Salim653/mizuro-ksti2026-muv/program/sim-viz/samples/viz_mid120.jpg

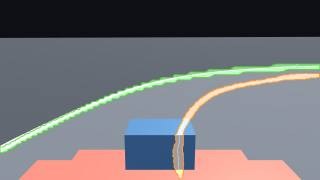
program/sim-viz/samples/viz_mid120.jpg
