Salim653/mizuro-ksti2026-muv/program/sim-viz/samples/viz_rear040.jpg

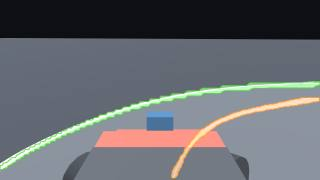
program/sim-viz/samples/viz_rear040.jpg
