Salim653/mizuro-ksti2026-muv/mechanical/README.md

# Mekanikal

Simpan CAD sasis, gambar kerja, dan catatan perakitan yang sudah terverifikasi di sini. Arah proyek saat ini: sasis FRP side-plate, penggerak roda belakang melalui satu differential terbuka, dan kemudi depan Ackermann.

## Batasan desain yang perlu dicek

- Batas lomba: lebar jejak roda 130–350 mm; wheelbase 160–550 mm; lebar total ≤400 mm; panjang ≤600 mm; tinggi ≤450 mm.
- Differential mekanis wajib; tidak boleh diganti e-differential.
- Kewajiban differential terbuka sebaiknya dikonfirmasi di Technical Meeting.
- Cek kompatibilitas hex roda 12 mm / hub M4 / driveshaft terhadap part yang benar-benar dibeli.
- FRP butuh backing plate/ring di titik pengencang; pakai cross-member agar dua rel tidak racking; isolasi tiang kamera dari getaran.
- Simpan file sumber CAD bersama hasil ekspornya; catat satuan, revisi, dan material untuk setiap part yang dirilis.

Belum ada CAD yang disalin ke folder ini; file sumber tetap berada di workspace lama.
