Salim653/mizuro-ksti2026-muv/mechanical/3d design/JETSON ORIN NANO/Design Data/Design Accelerator/Report/Spline1/Spline1.htm

### $$GrpGuide$

$$GLoads$ - $$guide_SCN1$

$$GStrength$ - $$guide_SCN2$

### $$GrpLoads$

$$description_P$ | $$designation_P$ | $$value_P$
$$description_n$ | $$designation_n$ | $$value_n$
$$description_T$ | $$designation_T$ | $$value_T$

### $$Dim$

$$description_Do$ | $$designation_Do$ | $$value_Do$
$$description_dh$ | $$designation_dh$ | $$value_dh$

### $$GrpProperties$

$$description_Km$ | $$designation_Km$ | $$value_Km$
$$description_Ks$ | $$designation_Ks$ | $$value_Ks$
$$description_Sv$ | $$designation_Sv$ | $$value_Sv$

### $$GrpMaterial$

| $$SHAFTMATERIAL$ | | $$HUBMATERIAL$

### $$GrpResults$

$$description_CHECK$ | $$value_CHECK$
$$description_dmin$ | $$designation_dmin$ | $$value_dmin$
$$description_lmin$ | $$designation_lmin$ | $$value_lmin$

##### $$Shaft$

$$description_pAc$ | $$designation_pAc$ | $$value_pAc$
$$description_S2$ | $$designation_S2$ | $$value_S2$

##### $$Hub$

$$description_Tauc$ | $$designation_Tauc$ | $$value_Tauc$
$$description_S3$ | $$designation_S3$ | $$value_S3$

### $$ErrorManager$

$$ErrorManagerMessages$
