Salim653/mizuro-ksti2026-muv/program/arena-3d/sanity_overlay.png

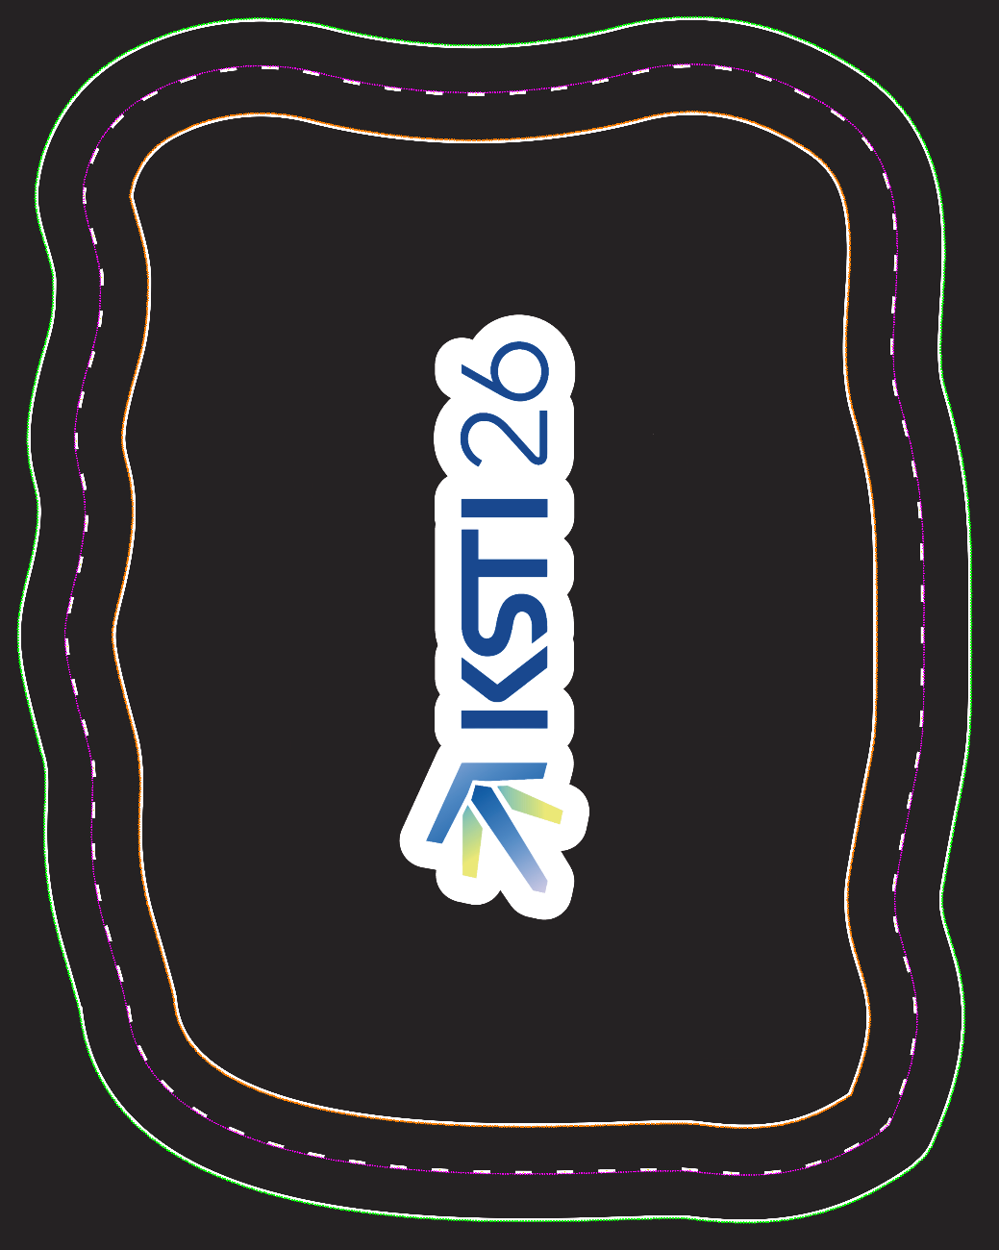
program/arena-3d/sanity_overlay.png
