Salim653/mizuro-ksti2026-muv/program/sim-viz/samples/viz_rear120.jpg

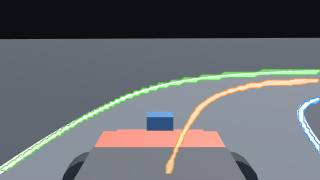
program/sim-viz/samples/viz_rear120.jpg
