Salim653/mizuro-ksti2026-muv/mechanical/3d design/BOX SPIDER.stp

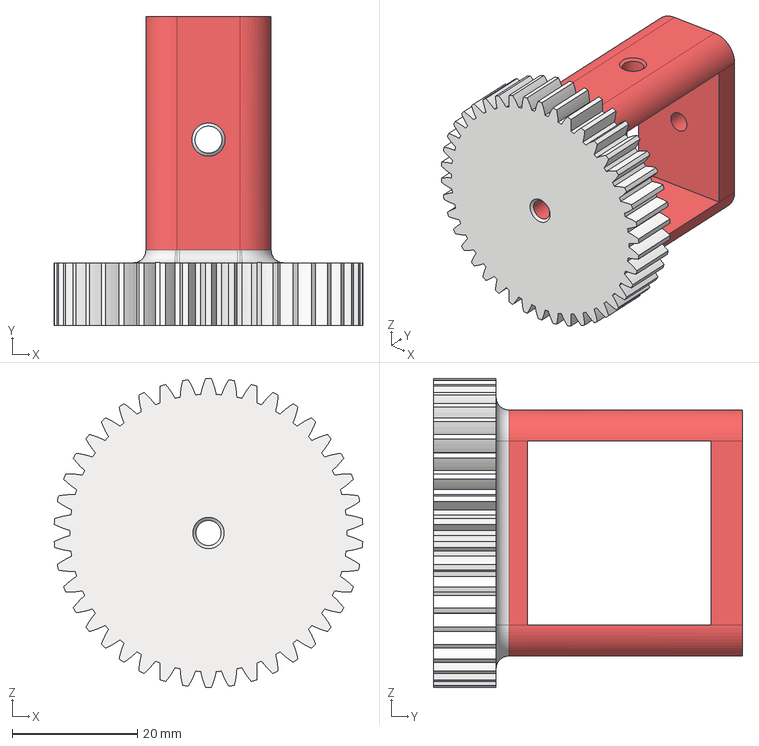
[picture p35: CAD file, 2026-10-22]
mechanical/3d design/BOX SPIDER.stp
49.2 x 49.3 x 49.3 mm
