Salim653/mizuro-ksti2026-muv/mechanical/3d print/Bevel Gear12.stp

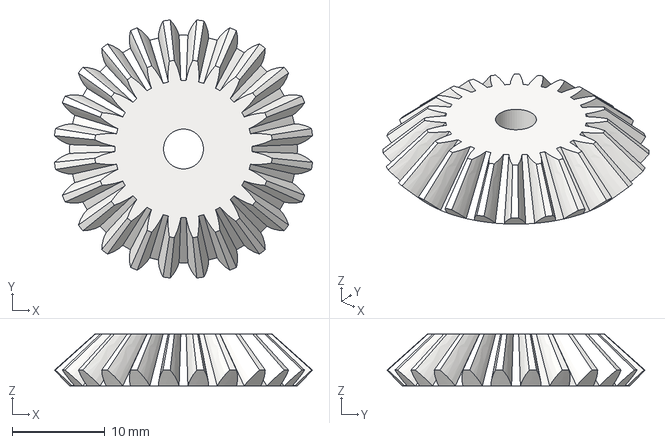
[picture p36: CAD file, 2026-10-22]
mechanical/3d print/Bevel Gear12.stp
27.8 x 27.8 x 5.60 mm
