Salim653/mizuro-ksti2026-muv/mechanical/3d print/WHEEL RIM.stl

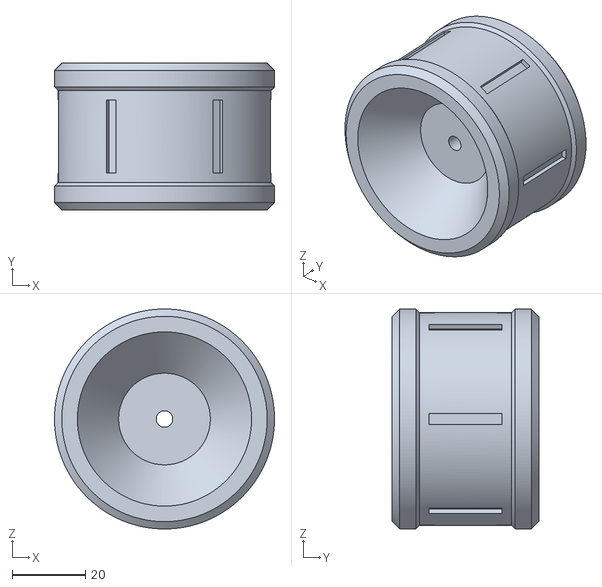
[picture p37: CAD file, 2026-10-22]
mechanical/3d print/WHEEL RIM.stl
60.0 x 40.0 x 60.0
