Salim653/mizuro-ksti2026-muv/(list of files, cad)

Other CAD files:
mechanical/3d design/JETSON ORIN NANO/Templates/English/ANSI (in).dwg
mechanical/3d design/JETSON ORIN NANO/Templates/Metric/JIS.dwg
mechanical/3d design/JETSON ORIN NANO/Templates/Standard.dwg
mechanical/3d design/JETSON ORIN NANO/Templates/Metric/BSI.dwg
mechanical/3d print/Part1.stp
mechanical/3d design/JETSON ORIN NANO/Templates/Metric/DIN.dwg
mechanical/3d design/JETSON ORIN NANO/Templates/Metric/ANSI (mm).dwg
mechanical/3d print/Bevel Gear22.stp
mechanical/3d design/JETSON ORIN NANO/Templates/Metric/GB.dwg
mechanical/3d design/JETSON ORIN NANO/Templates/Metric/GOST.dwg
mechanical/3d design/JETSON ORIN NANO/Templates/Metric/ISO.dwg
mechanical/3d design/2ND GEAR.ipt
mechanical/3d design/2ND STEP GEAR.iam
mechanical/3d design/3DP DIFF.iam
mechanical/3d design/3DP DIFF/Design Accelerator/Bevel Gear11.ipt
mechanical/3d design/3DP DIFF/Design Accelerator/Bevel Gear12.ipt
mechanical/3d design/3DP DIFF/Design Accelerator/Bevel Gear12_MIR.ipt
mechanical/3d design/3DP DIFF/Design Accelerator/Bevel Gear21.ipt
mechanical/3d design/3DP DIFF/Design Accelerator/Bevel Gear22.ipt
mechanical/3d design/3DP DIFF/Design Accelerator/Bevel Gear22_MIR.ipt
mechanical/3d design/3DP DIFF/Design Accelerator/Bevel Gears1.iam
mechanical/3d design/3DP DIFF/Design Accelerator/Bevel Gears2.iam
mechanical/3d design/3DP DIFF/Design Accelerator/Bevel Gears2_MIR.iam
mechanical/3d design/3DP DIFF/Design Accelerator/Bevel Gears2_MIR1.iam
mechanical/3d design/3DP DIFF/Design Accelerator/OldVersions/Bevel Gear12.0005.ipt
mechanical/3d design/3DP DIFF/Design Accelerator/OldVersions/Bevel Gear12_MIR.0001.ipt
mechanical/3d design/3DP DIFF/Design Accelerator/OldVersions/Bevel Gear22.0005.ipt
mechanical/3d design/3DP DIFF/Design Accelerator/OldVersions/Bevel Gear22_MIR.0001.ipt
mechanical/3d design/3DP DIFF/Design Accelerator/OldVersions/Bevel Gears2.0003.iam
mechanical/3d design/3DP DIFF/Design Accelerator/OldVersions/Bevel Gears2_MIR.0001.iam
mechanical/3d design/3DP DIFF/Design Accelerator/OldVersions/Bevel Gears2_MIR1.0001.iam
mechanical/3d design/3DP DIFF/Design Accelerator/OldVersions/Spur Gear12.0003.ipt
mechanical/3d design/3DP DIFF/Design Accelerator/OldVersions/Spur Gear13.0002.ipt
mechanical/3d design/3DP DIFF/Design Accelerator/OldVersions/Spur Gear21.0002.ipt
mechanical/3d design/3DP DIFF/Design Accelerator/OldVersions/Spur Gear22.0002.ipt
mechanical/3d design/3DP DIFF/Design Accelerator/OldVersions/Spur Gears2.0003.iam
mechanical/3d design/3DP DIFF/Design Accelerator/OldVersions/Spur Gears3.0003.iam
mechanical/3d design/3DP DIFF/Design Accelerator/Spur Gear11.ipt
mechanical/3d design/3DP DIFF/Design Accelerator/Spur Gear12.ipt
mechanical/3d design/3DP DIFF/Design Accelerator/Spur Gear13.ipt
mechanical/3d design/3DP DIFF/Design Accelerator/Spur Gear21.ipt
mechanical/3d design/3DP DIFF/Design Accelerator/Spur Gear22.ipt
mechanical/3d design/3DP DIFF/Design Accelerator/Spur Gears1.iam
mechanical/3d design/3DP DIFF/Design Accelerator/Spur Gears2.iam
mechanical/3d design/3DP DIFF/Design Accelerator/Spur Gears3.iam
mechanical/3d design/4MM ROD.ipt
mechanical/3d design/77MM-4MM ROD.ipt
mechanical/3d design/BEVEL+SPIDER BOX.iam
mechanical/3d design/BOX SPIDER.ipt
mechanical/3d design/CHASSIS PLATE.ipt
mechanical/3d design/DIFF ASSEM.iam
mechanical/3d design/DIFF CASE.ipt
mechanical/3d design/JETSON ORIN NANO/032-0681-000_1.ipt
mechanical/3d design/JETSON ORIN NANO/032-0696-000_1.ipt
mechanical/3d design/JETSON ORIN NANO/032-0796-000_1.ipt
mechanical/3d design/JETSON ORIN NANO/0402_H040.ipt
mechanical/3d design/JETSON ORIN NANO/0402_H060.ipt
mechanical/3d design/JETSON ORIN NANO/0603_H060.ipt
mechanical/3d design/JETSON ORIN NANO/0603_H100.ipt
mechanical/3d design/JETSON ORIN NANO/064-0267-000_1.ipt
mechanical/3d design/JETSON ORIN NANO/064-0404-000_1.ipt
mechanical/3d design/JETSON ORIN NANO/064-0437-000_1.ipt
mechanical/3d design/JETSON ORIN NANO/065-0738-000_1.ipt
mechanical/3d design/JETSON ORIN NANO/074-0221-000_3.ipt
mechanical/3d design/JETSON ORIN NANO/074-0239-000_1.ipt
mechanical/3d design/JETSON ORIN NANO/080-1243-000_3.ipt
mechanical/3d design/JETSON ORIN NANO/080-1263-000_1_OBSOLETE.ipt
mechanical/3d design/JETSON ORIN NANO/080-1263-000_2.ipt
mechanical/3d design/JETSON ORIN NANO/080-1483-000_2.ipt
mechanical/3d design/JETSON ORIN NANO/080-1655-000_3.ipt
mechanical/3d design/JETSON ORIN NANO/080-1656-000_3.ipt
mechanical/3d design/JETSON ORIN NANO/080-1890-000_1.ipt
mechanical/3d design/JETSON ORIN NANO/080-1898-000_1.ipt
mechanical/3d design/JETSON ORIN NANO/080-2191-000_1.ipt
mechanical/3d design/JETSON ORIN NANO/0805_H140.ipt
mechanical/3d design/JETSON ORIN NANO/0805_H150.ipt
mechanical/3d design/JETSON ORIN NANO/0805_H160.ipt
mechanical/3d design/JETSON ORIN NANO/085-0347-000_1.ipt
mechanical/3d design/JETSON ORIN NANO/086-0311-000_1.ipt
mechanical/3d design/JETSON ORIN NANO/090-0155-000_1.ipt
mechanical/3d design/JETSON ORIN NANO/090-0172-000_1.ipt
mechanical/3d design/JETSON ORIN NANO/090-0243-000_1.ipt
mechanical/3d design/JETSON ORIN NANO/090-0296-000_2.ipt
mechanical/3d design/JETSON ORIN NANO/090-0343-000_1.ipt
mechanical/3d design/JETSON ORIN NANO/090-0377-000_1.ipt
mechanical/3d design/JETSON ORIN NANO/090-0378-000_1.ipt
mechanical/3d design/JETSON ORIN NANO/091-0022-000_1.ipt
mechanical/3d design/JETSON ORIN NANO/092-0073-000_1.ipt
mechanical/3d design/JETSON ORIN NANO/095-0180-000-TS1.ipt
mechanical/3d design/JETSON ORIN NANO/095-0180-000-TS1_ASM.iam
mechanical/3d design/JETSON ORIN NANO/115-0085-000_1.ipt
mechanical/3d design/JETSON ORIN NANO/115-0138-000_1.ipt
mechanical/3d design/JETSON ORIN NANO/115-0655-000_3.ipt
mechanical/3d design/JETSON ORIN NANO/115-1921-000_3.ipt
mechanical/3d design/JETSON ORIN NANO/115-2177-000_2.ipt
mechanical/3d design/JETSON ORIN NANO/115-2544-000_1.ipt
mechanical/3d design/JETSON ORIN NANO/115-2747-000_1.ipt
mechanical/3d design/JETSON ORIN NANO/115-2766-000_1.ipt
mechanical/3d design/JETSON ORIN NANO/115-2791-000_1.ipt
mechanical/3d design/JETSON ORIN NANO/115-2838-000_1.ipt
mechanical/3d design/JETSON ORIN NANO/115-3110-000_1.ipt
mechanical/3d design/JETSON ORIN NANO/1206_H180.ipt
mechanical/3d design/JETSON ORIN NANO/130-1221-000_1.ipt
mechanical/3d design/JETSON ORIN NANO/130-1404-000_1.ipt
mechanical/3d design/JETSON ORIN NANO/142-13526-1000-A01-SKU0000.ipt
mechanical/3d design/JETSON ORIN NANO/142-13526-1000-A01-SKU0000_ASM.iam
mechanical/3d design/JETSON ORIN NANO/155-0576-000.ipt
mechanical/3d design/JETSON ORIN NANO/155-0697-000_2_AF0.ipt
mechanical/3d design/JETSON ORIN NANO/155-0697-000_2_AF1.ipt
mechanical/3d design/JETSON ORIN NANO/155-0697-000_2_AF2.ipt
mechanical/3d design/JETSON ORIN NANO/155-0899-000.ipt
mechanical/3d design/JETSON ORIN NANO/155-0900-000.ipt
mechanical/3d design/JETSON ORIN NANO/155-0901-000.ipt
mechanical/3d design/JETSON ORIN NANO/155-GROGU-000.ipt
mechanical/3d design/JETSON ORIN NANO/174-0159-000_2.ipt
mechanical/3d design/JETSON ORIN NANO/195-3883-000_1.ipt
mechanical/3d design/JETSON ORIN NANO/2020 PROFILE BASE.ipt
mechanical/3d design/JETSON ORIN NANO/300-0518-000_1.ipt
mechanical/3d design/JETSON ORIN NANO/300-0859-000_1.ipt
mechanical/3d design/JETSON ORIN NANO/300-0868-000_3.ipt
mechanical/3d design/JETSON ORIN NANO/300-0906-000_1.ipt
mechanical/3d design/JETSON ORIN NANO/300-1070-000_3.ipt
mechanical/3d design/JETSON ORIN NANO/300-1133-000_1.ipt
mechanical/3d design/JETSON ORIN NANO/300-1185-000_1.ipt
mechanical/3d design/JETSON ORIN NANO/300-1253-000_1.ipt
mechanical/3d design/JETSON ORIN NANO/300-1278-000_1.ipt
mechanical/3d design/JETSON ORIN NANO/315-0992-000_1.ipt
mechanical/3d design/JETSON ORIN NANO/315-1022-000_1.ipt
mechanical/3d design/JETSON ORIN NANO/316-0538-000_1.ipt
mechanical/3d design/JETSON ORIN NANO/316-0703-000_1.ipt
mechanical/3d design/JETSON ORIN NANO/320-1004-000_2.ipt
mechanical/3d design/JETSON ORIN NANO/330-0266-000_M2_WIFI_MODULE_ASM.iam
mechanical/3d design/JETSON ORIN NANO/330-0266-000_MODULE_BOARD.ipt
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
