Salim653/mizuro-ksti2026-muv/program/robot/mizuro/config.py

"""Konfigurasi runtime robot.

Config dimuat dari file JSON. Key yang tidak dikenal DITOLAK supaya salah
ketik tidak pernah diterapkan diam-diam, dan setiap rentang divalidasi saat
load. Batas kecepatan/kemudi berasal dari protokol serial (protocol.py) dan
tidak boleh dilebihi tanpa mengubah firmware MCU juga.
"""
from __future__ import annotations

import json
from dataclasses import dataclass, fields
from pathlib import Path

from .protocol import (
    DEFAULT_BAUD,
    FIRMWARE_MODES,
    MAX_SPEED_MPS,
    MAX_STEER_RAD,
)

# motor_driver yang sah = kunci FIRMWARE_MODES (sumber kebenaran tunggal
# bersama firmware: menambah hardware berarti menambah entri di sana).
MOTOR_DRIVERS = frozenset(FIRMWARE_MODES)
LANE_POLARITIES = {"auto", "light_on_dark", "dark_on_light"}
CHECKPOINT_MODES = {"none", "cv", "model"}


@dataclass(frozen=True)
class Config:
    """Seluruh setelan runtime. Default-nya sengaja paling aman (dry_run)."""

    # --- output run ---
    output_dir: str = "runs"

    # --- serial ke MCU bodi ---
    serial_device: str = ""
    serial_baud: int = DEFAULT_BAUD

    # --- kamera ---
    # camera_pipeline kosong = pipeline CSI bawaan (nvarguscamerasrc).
    camera_pipeline: str = ""
    image_width: int = 1280
    image_height: int = 720
    camera_fps: int = 30

    # --- posisi & orientasi kamera relatif titik referensi robot ---
    # Titik referensi = poras belakang (default anchor arena-3d). Posisi
    # dalam meter, orientasi dalam derajat — diukur saat bench, bukan
    # ditebak. mount_z/pitch default = mount arena-3d.
    mount_x_m: float = 0.0          # maju (+) / mundur (-) dari poras
    mount_y_m: float = 0.0          # kanan (+) / kiri (-)
    mount_z_m: float = 0.16         # tinggi lensa dari tanah
    mount_pitch_deg: float = 12.0   # positif = lensa menghadap ke BAWAH
    mount_yaw_deg: float = 0.0      # positif = optical axis ke KANAN robot
    mount_roll_deg: float = 0.0     # positif = kamera roll CCW dari belakang

    # --- persepsi lajur (Fase 1) ---
    lane_polarity: str = "auto"      # auto | light_on_dark | dark_on_light
    lane_roi_top: float = 0.35       # batas atas ROI, fraksi tinggi frame
    lane_min_confidence: float = 0.3
    homography_path: str = ""        # kalibrasi kamera -> bidang tanah

    # --- detektor semantik (Fase 2) ---
    model_path: str = ""
    confidence_threshold: float = 0.5

    # --- deteksi checkpoint (Fase 5) ---
    # none = mati (lane keeping tetap jalan) | cv = classical CV warna
    # | model = YOLO ONNX (butuh model terlatih kelas arena)
    checkpoint_mode: str = "none"
    checkpoint_color: str = "green"        # preset: green/red/orange/yellow/blue
    checkpoint_hsv_low: tuple = ()         # kosong = pakai preset warna
    checkpoint_hsv_high: tuple = ()
    checkpoint_min_area_px: int = 300
    checkpoint_max_area_px: int = 400000
    checkpoint_min_solidity: float = 0.3
    checkpoint_label: str = "checkpoint"

    # --- kontrol ---
    max_speed_mps: float = MAX_SPEED_MPS
    steering_limit_rad: float = MAX_STEER_RAD
    lookahead_m: float = 0.6
    heading_gain: float = 0.8
    lateral_gain: float = 1.2
    max_lateral_accel: float = 3.0
    min_speed_mps: float = 0.15
    max_accel_mps2: float = 0.5
    max_decel_mps2: float = 1.0
    stanley_softening_mps: float = 0.1
    min_curve_radius_m: float = 1.5

    # --- loop & keselamatan ---
    loop_hz: float = 60.0
    max_inference_ms: float = 150.0
    lane_lost_frames: int = 3
    run_timeout_s: float = 300.0     # batas waktu percobaan lomba

    # --- mode ---
    dry_run: bool = True
    save_frames: bool = False
    # Tahap output firmware MCU. skid4_l298n = prototype SEKARANG
    # (4x L298N, skid steer, mixing di MCU). Ganti ke external_esc saat
    # pindah ke mekanik kompetisi (1x ESC brushless + servo kemudi).
    # Diteruskan ke MCU sebagai #M,<mode> saat port serial dibuka.
    motor_driver: str = "skid4_l298n"

    # --- stream kamera (bench/pit saja; MATIKAN saat lomba) ---
    stream_enabled: bool = False
    stream_host: str = "127.0.0.1"   # 0.0.0.0 hanya untuk jaringan pit tepercaya
    stream_port: int = 8080
    stream_fps: float = 15.0
    stream_quality: int = 75
    stream_width: int = 640          # 0 = resolusi kamera penuh
    stream_height: int = 480

    @classmethod
    def load(cls, path: Path) -> "Config":
        """Muat + validasi config dari file JSON."""
        path = Path(path)
        try:
            text = path.read_text(encoding="utf-8")
        except FileNotFoundError as exc:
            raise ValueError(f"file config tidak ada: {path}") from exc
        try:
            data = json.loads(text)
        except json.JSONDecodeError as exc:
            raise ValueError(f"config bukan JSON valid: {path} ({exc})") from exc
        if not isinstance(data, dict):
            raise ValueError("config harus berupa objek JSON")
        known = {f.name for f in fields(cls)}
        unknown = sorted(set(data) - known)
        if unknown:
            raise ValueError(f"key config tidak dikenal: {unknown}")
        try:
            cfg = cls(**data)
            cfg.validate()
        except TypeError as exc:
            # dataclass tidak memeriksa tipe; salah tipe muncul sebagai
            # TypeError saat validasi — ubah menjadi ValueError yang jelas.
            raise ValueError(f"tipe key config salah: {exc}") from exc
        return cfg

    def validate(self) -> None:
        self._check_types()
        if not 0.0 <= self.confidence_threshold <= 1.0:
            raise ValueError("confidence_threshold harus dalam [0, 1]")
        if not 0.0 <= self.lane_min_confidence <= 1.0:
            raise ValueError("lane_min_confidence harus dalam [0, 1]")
        if not 0.0 < self.lane_roi_top < 1.0:
            raise ValueError("lane_roi_top harus fraksi (0, 1)")
        if self.lane_polarity not in LANE_POLARITIES:
            raise ValueError(
                f"lane_polarity harus salah satu dari {sorted(LANE_POLARITIES)}")
        if self.image_width <= 0 or self.image_height <= 0 or self.camera_fps <= 0:
            raise ValueError("dimensi dan fps kamera harus positif")
        if not 0.0 < self.mount_z_m <= 1.0:
            raise ValueError("mount_z_m harus dalam (0, 1] meter")
        if abs(self.mount_x_m) > 1.0 or abs(self.mount_y_m) > 1.0:
            raise ValueError(
                "offset mount_x_m/mount_y_m tidak masuk akal (> 1 m)")
        if not -80.0 <= self.mount_pitch_deg <= 80.0:
            raise ValueError("mount_pitch_deg harus dalam [-80, 80] derajat")
        if abs(self.mount_yaw_deg) > 45.0 or abs(self.mount_roll_deg) > 45.0:
            raise ValueError(
                "mount_yaw_deg/mount_roll_deg harus dalam ±45 derajat")
        if self.serial_baud <= 0:
            raise ValueError("serial_baud harus positif")
        if not 0.0 < self.max_speed_mps <= MAX_SPEED_MPS:
            raise ValueError(
                f"max_speed_mps harus dalam (0, {MAX_SPEED_MPS}] — batas protokol")
        if not 0.0 < self.steering_limit_rad <= MAX_STEER_RAD:
            raise ValueError(
                f"steering_limit_rad harus dalam (0, {MAX_STEER_RAD}] — batas protokol")
        if self.lookahead_m <= 0:
            raise ValueError("lookahead_m harus positif")
        if self.heading_gain < 0 or self.lateral_gain < 0:
            raise ValueError("gain kontrol tidak boleh negatif")
        if self.max_lateral_accel <= 0:
            raise ValueError("max_lateral_accel harus positif")
        if not 0.0 <= self.min_speed_mps <= self.max_speed_mps:
            raise ValueError(
                "min_speed_mps harus dalam [0, max_speed_mps]")
        if self.max_accel_mps2 <= 0 or self.max_decel_mps2 <= 0:
            raise ValueError("max_accel/decel_mps2 harus positif")
        if self.stanley_softening_mps < 0:
            raise ValueError("stanley_softening_mps tidak boleh negatif")
        if self.min_curve_radius_m <= 0:
            raise ValueError("min_curve_radius_m harus positif")
        if self.loop_hz <= 0:
            raise ValueError("loop_hz harus positif")
        if self.max_inference_ms <= 0:
            raise ValueError("max_inference_ms harus positif")
        if self.lane_lost_frames < 1:
            raise ValueError("lane_lost_frames minimal 1")
        if self.run_timeout_s <= 0:
            raise ValueError("run_timeout_s harus positif")
        if self.motor_driver not in MOTOR_DRIVERS:
            raise ValueError(
                f"motor_driver harus salah satu dari {sorted(MOTOR_DRIVERS)}")
        if self.checkpoint_mode not in CHECKPOINT_MODES:
            raise ValueError(
                f"checkpoint_mode harus salah satu dari {sorted(CHECKPOINT_MODES)}")
        if self.checkpoint_mode == "model" and not self.model_path:
            raise ValueError(
                "checkpoint_mode 'model' mensyaratkan model_path")
        for name in ("checkpoint_hsv_low", "checkpoint_hsv_high"):
            value = getattr(self, name)
            if not isinstance(value, (tuple, list)) or len(value) not in (0, 3):
                raise ValueError(
                    f"{name} harus tuple 3 angka (H, S, V) atau kosong")
            if not all(isinstance(v, (int, float)) and not isinstance(v, bool)
                       for v in value):
                raise ValueError(f"{name} harus berisi angka")
        if self.checkpoint_hsv_low and self.checkpoint_hsv_high:
            if not (self.checkpoint_hsv_low[0] <= self.checkpoint_hsv_high[0]
                    and self.checkpoint_hsv_low[1] <= self.checkpoint_hsv_high[1]
                    and self.checkpoint_hsv_low[2] <= self.checkpoint_hsv_high[2]):
                raise ValueError(
                    "checkpoint_hsv_low harus <= checkpoint_hsv_high per kanal")
        if not 0 < self.checkpoint_min_area_px <= self.checkpoint_max_area_px:
            raise ValueError(
                "checkpoint_min_area_px harus dalam (0, max_area_px]")
        if not 0.0 <= self.checkpoint_min_solidity <= 1.0:
            raise ValueError("checkpoint_min_solidity harus dalam [0, 1]")
        if not 1 <= self.stream_port <= 65535:
            raise ValueError("stream_port harus dalam [1, 65535]")
        if self.stream_fps <= 0 or not 1 <= self.stream_quality <= 100:
            raise ValueError("stream_fps harus positif dan stream_quality dalam [1, 100]")
        if self.stream_width < 0 or self.stream_height < 0:
            raise ValueError("dimensi stream harus >= 0 (0 = resolusi kamera)")
        if self.save_frames and self.dry_run:
            raise ValueError("save_frames butuh capture live (matikan dry_run)")
        if not self.dry_run:
            if not self.serial_device:
                raise ValueError("mode live mensyaratkan serial_device")
            # model_path tidak lagi wajib di live: checkpoint_mode
            # mengatur. "model" butuh model_path (divalidasi di atas),
            # "cv"/"none" jalan tanpa model.

    def _check_types(self) -> None:
        """Dataclass tidak memeriksa tipe; salah tipe bisa mengubah arti
        (mis. dry_run string dianggap truthy = live). Periksa eksplisit."""
        bools = ("dry_run", "save_frames")
        strs = ("output_dir", "serial_device", "camera_pipeline",
                "lane_polarity", "homography_path", "model_path",
                "motor_driver", "stream_host",
                "checkpoint_mode", "checkpoint_color", "checkpoint_label")
        ints = ("serial_baud", "image_width", "image_height", "camera_fps",
                "lane_lost_frames", "stream_port", "stream_quality",
                "stream_width", "stream_height",
                "checkpoint_min_area_px", "checkpoint_max_area_px")
        floats = ("confidence_threshold", "lane_min_confidence", "lane_roi_top",
                  "max_speed_mps", "steering_limit_rad", "lookahead_m",
                  "heading_gain", "lateral_gain", "max_lateral_accel",
                  "min_speed_mps", "max_accel_mps2", "max_decel_mps2",
                  "stanley_softening_mps", "min_curve_radius_m",
                  "loop_hz", "max_inference_ms", "run_timeout_s", "stream_fps",
                  "mount_x_m", "mount_y_m", "mount_z_m", "mount_pitch_deg",
                  "mount_yaw_deg", "mount_roll_deg",
                  "checkpoint_min_solidity")
        for name in bools:
            if not isinstance(getattr(self, name), bool):
                raise ValueError(f"tipe salah: {name} harus bool")
        for name in strs:
            if not isinstance(getattr(self, name), str):
                raise ValueError(f"tipe salah: {name} harus string")
        for name in ints:
            value = getattr(self, name)
            if isinstance(value, bool) or not isinstance(value, int):
                raise ValueError(f"tipe salah: {name} harus integer")
        for name in floats:
            value = getattr(self, name)
            if isinstance(value, bool) or not isinstance(value, (int, float)):
                raise ValueError(f"tipe salah: {name} harus angka")
        if not self.output_dir.strip():
            raise ValueError("output_dir tidak boleh kosong")
