Salim653/mizuro-ksti2026-muv/(commit log)

2026-10-18 Terjemahkan dokumentasi repositori ke Bahasa Indonesia
    - README root, electronic/, mechanical/, program/jetson/, program/body-mcu/
    - Ringkasan guidebook dipindah ke docs/ dan diterjemahkan
    - Tambah docs/README.md sebagai indeks dokumentasi
    - Hapus duplikat ringkasan guidebook di root
    - Catatan kerja internal di docs/project-notes/ dibiarkan apa adanya
2026-10-19 Add chassis and wheel CAD designs
    [CHASSIS PLATE.ipt, KSTI-MUV ASSEM.iam, WHEEL RIM.ipt, WHEEL TIRE.ipt]
2026-10-19 Add missing files
    [032-0681-000_1.ipt, 032-0696-000_1.ipt, 032-0796-000_1.ipt, 0402_H040.ipt, 0402_H060.ipt, 0603_H060.ipt, 0603_H100.ipt, 064-0267-000_1.ipt]
2026-10-19 Track simulation model asset
2026-10-22 Add differential assembly, gearbox, and 3D print exports
    - New differential parts: DIFF CASE, DIFF ASSEM, 3DP DIFF, bevel/spider gearbox
    - New gear train: 2ND GEAR, 2ND STEP GEAR, SPIDER GEAR BOX, 4MM rod parts
    - Updated chassis plate, wheel rim, wheel tire, and top-level MUV assembly
    - 3D print exports (STL/STP) for bevel gears and wheel rim
    - Refresh Inventor OldVersions snapshots
    [2ND GEAR.0002.ipt, 2ND GEAR.ipt, 2ND STEP GEAR.0001.iam, 2ND STEP GEAR.0001_1.iam, 2ND STEP GEAR.iam, 3DP DIFF.0009.iam, 3DP DIFF.iam, 4MM ROD.0002.ipt]
2026-10-22 Sync Jetson camera stream and team handoff guide
    Keep the Jetson runtime updates and handoff documentation aligned across the laptop, Jetson checkout, and origin.
2026-10-29 Fase 1: persepsi lajur, kamera, stream, eval
    Detail di program/robot/CHANGELOG.md.
2026-10-29 Kamera: konfigurasi mount x/y/z + yaw/roll
    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
2026-10-29 Bench: mode --stream-only (kamera + MJPEG + tracker)
    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
2026-10-29 Kalibrasi kamera: tools/calibrate.py + wiring homography_path
    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
2026-10-29 Fase 2: detektor semantik ONNX (cv2.dnn) + export tool
    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
2026-10-29 Fase 3: controller Stanley + speed profile + replay sim
    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
2026-11-03 Fase 4: closed-loop runner (persepsi -> Stanley -> MCU)
    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
2026-11-03 Fase 5 groundwork: checkpoint_mode + detektor CV klasik
    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
2026-11-05 tools/record_dataset.py: kontrol manual SPACE/Q + default PNG
    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
2026-11-05 models/: direktori file model (gitignored)
    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
2026-11-06 dashboard: dashboard run full (HTML+JS terpisah) + flag --dashboard di main.py
    - dashboard.py (baru, stdlib only): server HTTP read-only untuk
    runs/run-*/telemetry.csv + events.jsonl. Endpoint /api/status (run
    terbaru atau ?run=), /api/runs, /api/history?points= (deret waktu,
    downsample indeks rata), /api/demo (data sintetis buat preview UI).
    Flag --runs/--host/--port/--self-check; tanpa dependensi luar jadi
    jalan dengan /usr/bin/python3 di Jetson apa adanya.
    - dashboard.html (baru): UI dipisah dari Python supaya bisa diedit tim
    tanpa sentuh kode server. URL MJPEG di-inject lewat token
    __FEED_URL__ yang di-escape oleh dashboard._js_string() (kutip,
    backslash, <) sebelum masuk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
2026-11-06 MCU v2: tiga mode output (skid4/esc1/hb1) + protokol status balik
    Firmware bodi ditulis ulang supaya satu sketsa melayani prototype
    SEKARANG (4x L298N, skid steer) DAN target kompetisi (ESC brushless +
    servo kemudi) tanpa flash ulang — mode dipilih runtime lewat serial.
    - body_controller.ino (v2): tiga mode output runtime-selectable
    (#M,<mode>\n): skid4 (4x L298N, mixing speed+steer -> roda kiri/kanan
    di MCU, steering_rad = yaw-rate ternormalisasi, clamp dua sisi
    bersama supaya rasio belok tetap, mendukung putar-di-tempat),
    esc1 (ESC servo-PWM + servo kemudi, deadband 40 us supaya perintah
    kecil benar-benar menggerakkan roda pada gir 1:10, arming hold 2 s),
    hb1 (bench: 1 motor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
2026-11-06 bench tanpa hardware: video sebagai kamera + MCU virtual
    Loop closed-loop penuh (persepsi -> Stanley -> MCU) sekarang bisa
    dijalankan tanpa Jetson, tanpa kamera, tanpa motor: kamera diganti file
    video dan MCU diganti cermin pemetaan output firmware di Python.
    - mizuro/camera.py: sumber file video. Heuristik: pipeline dengan '!'
    (atau appsink/nvarguscamerasrc) = GStreamer (perilaku lama, wajib
    backend GStreamer); selain itu = path file -> cv2.VideoCapture tanpa
    CAP_GSTREAMER, jadi replay jalan dengan cv2 pip .venv di laptop.
    Sumber file: ukuran beda di-resize ke ukuran config (CSI tetap
    DITOLAK — beda ukuran di CSI = bug kalibrasi), habis = EndOfVideo
    (bukan RuntimeError), vide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
    [camera.py, main.py, mcu.py, mcu_bench.py, runner.py]
2026-11-06 bench dashboard: kontrol sumber kamera CSI/video dari browser (--bench)
    Satu proses menjalankan dashboard + kontrol sumber kamera: toggle kamera
    CSI <-> file video + pemilih video, ditukar saat runtime tanpa restart
    proses. Tidak ada serial dan tidak ada motor di jalur ini.
    - mizuro/camera.py: CameraSource — sumber yang bisa ditukar (select,
    describe, switches, video_loop); docstring dikoreksi (wheel
    opencv-python di .venv MELAPORKAN GStreamer YES 1.20.3 dan membundel
    plugin nvstreamer, jadi yang gagal di laptop adalah read() "No
    cameras available", bukan pemeriksaan build info)
    - mizuro/bench_server.py (baru): BenchControl — loop kamera + tracker di
    thread, status hidup (fram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
